weimanc/cartreader/hardware/main_pcb_hw5/main_pcb_hw5_bottom.jpg

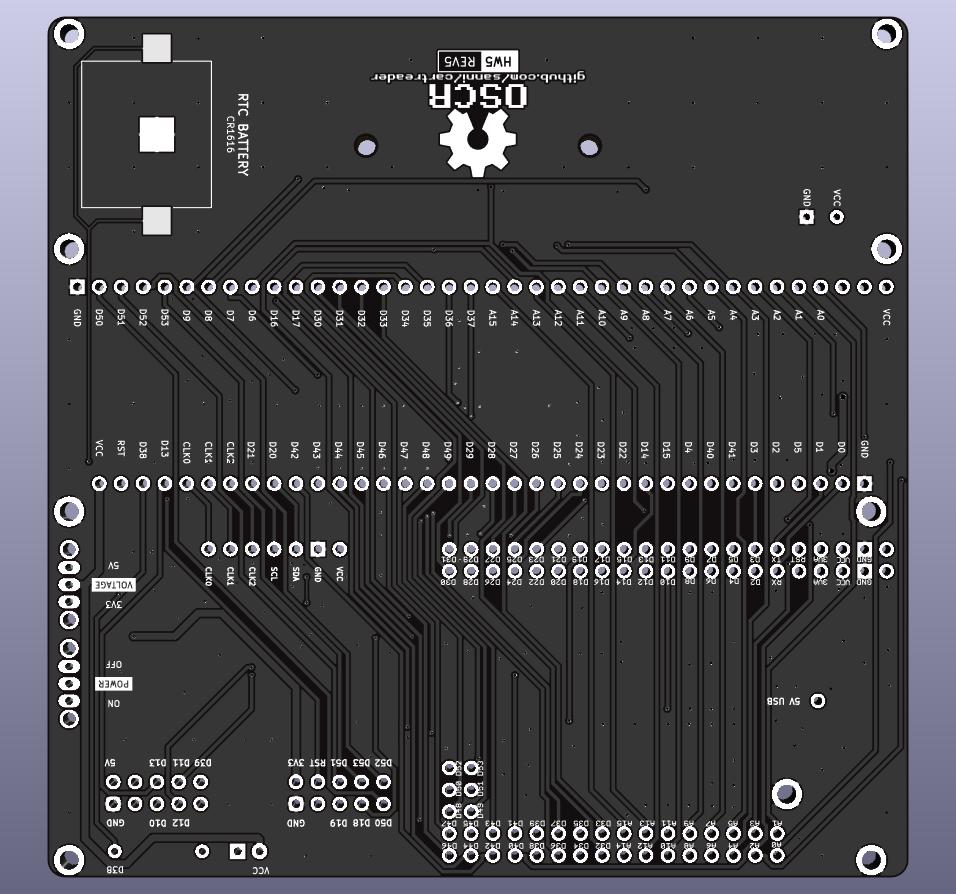
hardware/main_pcb_hw5/main_pcb_hw5_bottom.jpg
